show0k/lightsaber/README.md

#ENSEA-lightsaber

Project made during the ENSEA 2nd year.
More documentation will be here after the new version of the sound board.

Official website [french] lightsaber.ensea.fr

#Credits
Project made by Cédric P. (tiritchi) and Théo S. (show0k) directed by our teacher M. Tauvel.
