show0k/lightsaber/soft/README.md

#HOW TO USE THAT STUF
To compile the project, the easiest is 
* download, extract and install the arduino IDE corresonding to your OS (tested with v1.0.5)
* copy the librairy directory to your local arduino directory named librairy
** On GNU/Linux it is ~/sketchbook/libraries/ 
** On MacOS it is ~/Arduino/librairies/
** On Windows it is
* Open lightsaber.ino with your arduino IDE, and compile corresponding to your board.

#Advise
Arduino IDE is awfull, use the stino pluggin on SublimeText instead.

0665033470
