show0k/lightsaber/website/README.md

Samples pages that will be copied to http://lightsaber.ensea.fr
