show0k/lightsaber/hard/avr/328p/README.md

Board with ATMEGA328p directly wired.
Never fishish because is was to long to route it for the ENSEA quality.
