show0k/lightsaber/website/presentation-sabre.md

Le projet sabre laser à pout but de réaliser une réplique de l'arme fétiche de la trilogie de Star Wars.

Créer un faisceau laser très énergétique sur une distance finie étant soit disant impossible, nous nous sommes contentés de rélaliser une réplique réaliste, avec un pommeau en métal et un faiseau lumineux dans un tube diffusant. Le tout est équipé d'une carte électronique qui produit des sons de façon réaliste selon les mouvements de l'utilisateur.

Tout le projet est sous licence MIT, il est hébergé sur un dépôt git sur [GitHub](http://github.com/show0k/lightsaber). Vous pouvez télécharger [l'archive complete](https://github.com/show0k/lightsaber/archive/master.zip) ou [cloner le dépôt](git clone git@github.com:show0k/lightsaber.git). Soyez libre de proposer des amélioration ou soulever des problèmes avec le [gestionaire de bugs](https://github.com/show0k/lightsaber/issues) intégré à Github.
