show0k/lightsaber/website/credits.md

# Réalisation du sabre laser
Tout le projet a été réalisé par Cédric P. et Théo S. au cours du projet de deuxième année de l'ENSEA, encadré par [M. Tauvel](http://www.tauvel.net/).

Les librairies utilisées pour ce projet sont sous licence MIT (ADXL345) et GPL (FatReader et WaveHC).

Tout le code ainsi que les cartes électroniques de ce projet sont placés sous la licence MIT, ce qui autorise quiconque à utiliser, modifier et redistribuer les sources de notre projet à la seule condition de mentioner les auteurs originaux.

Tout le projet est hébergé sur un dépôt git sur [GitHub](http://github.com/show0k/lightsaber). Vous pouvez télécharger [l'archive complete](https://github.com/show0k/lightsaber/archive/master.zip) ou [cloner le dépôt](git@github.com:show0k/lightsaber.git). 
Si vous réalisez une carte de sabre laser en utilisant notre projet, c'est toujours agréable de recevoir un mail. Vous pouvez nous écrire à ***lightsaber @ ensea.fr***

# Site web
Ce site web est propulsé par [PluXml](http://www.pluxml.org/) avec un thème crée par [Fred](http://my.pluxml.free.fr/pluxml/) utilisant [Bootstrap](http://getbootstrap.com/) et adapté par nous même pour nos besoins.
