show0k/lightsaber/hard/avr/pro_mini/images/avr_saber_mini.sch.png

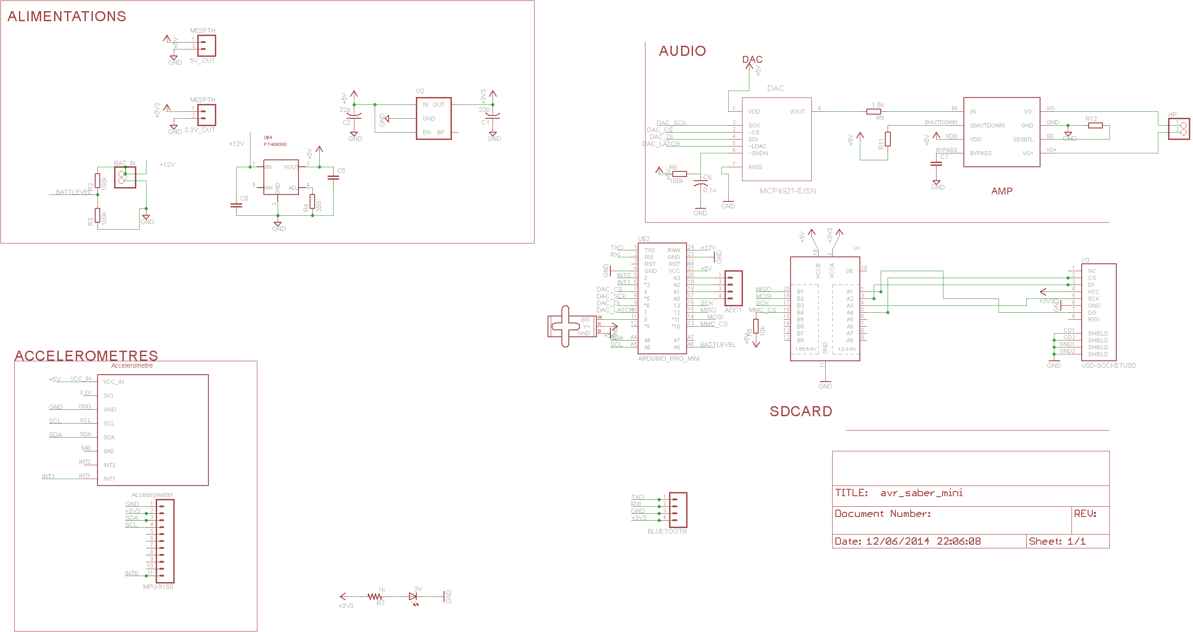
hard/avr/pro_mini/images/avr_saber_mini.sch.png
