show0k/lightsaber/hard/avr/pro_mini/images/bottom.png

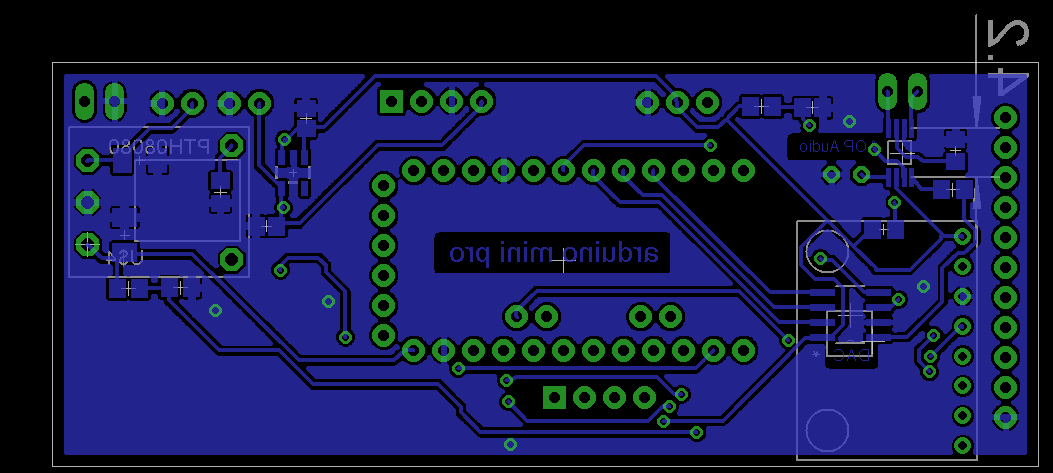
hard/avr/pro_mini/images/bottom.png
