show0k/lightsaber/hard/avr/pro_mini/images/top.png

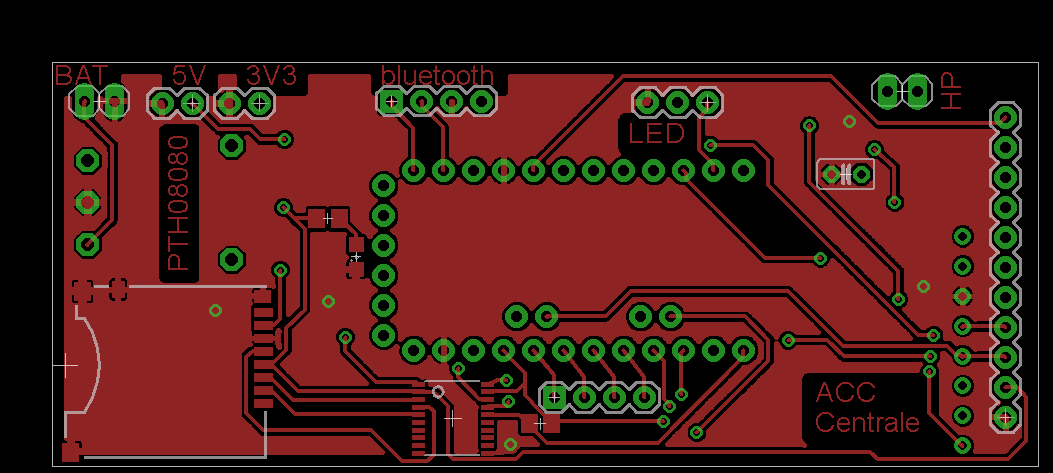
hard/avr/pro_mini/images/top.png
