show0k/lightsaber/hard/led/led_saber.bottom.pdf

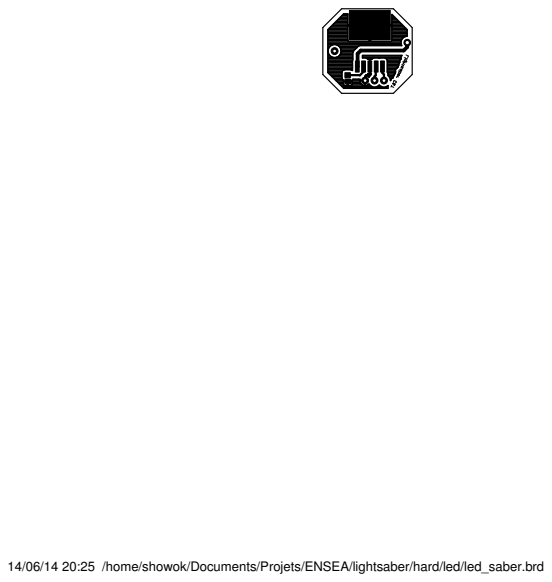
[picture p10: page 1]

14/06/14 20:25 /home/showok/Documents/Projets/ENSEA/lightsaber/hard/led/led_saber.brd
