show0k/lightsaber/hard/led/led_saber.top.pdf

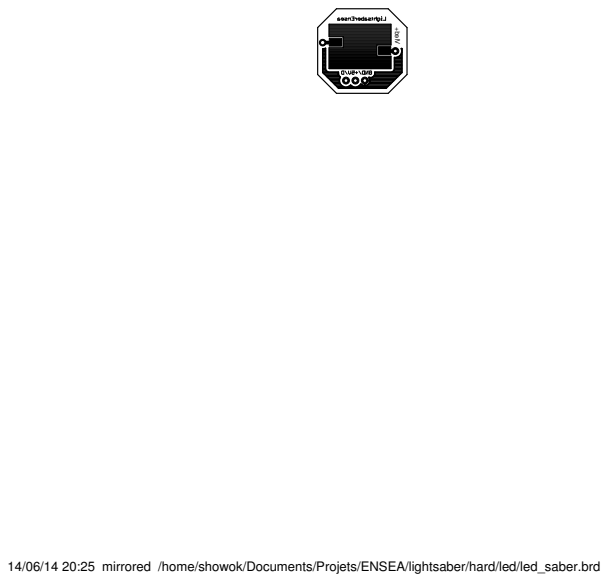
[picture p11: page 1]

14/06/14 20:25 mirrored /home/showok/Documents/Projets/ENSEA/lightsaber/hard/led/led_saber.brd
