show0k/lightsaber/hard/avr/pro_mini/avr_saber_mini.pdf

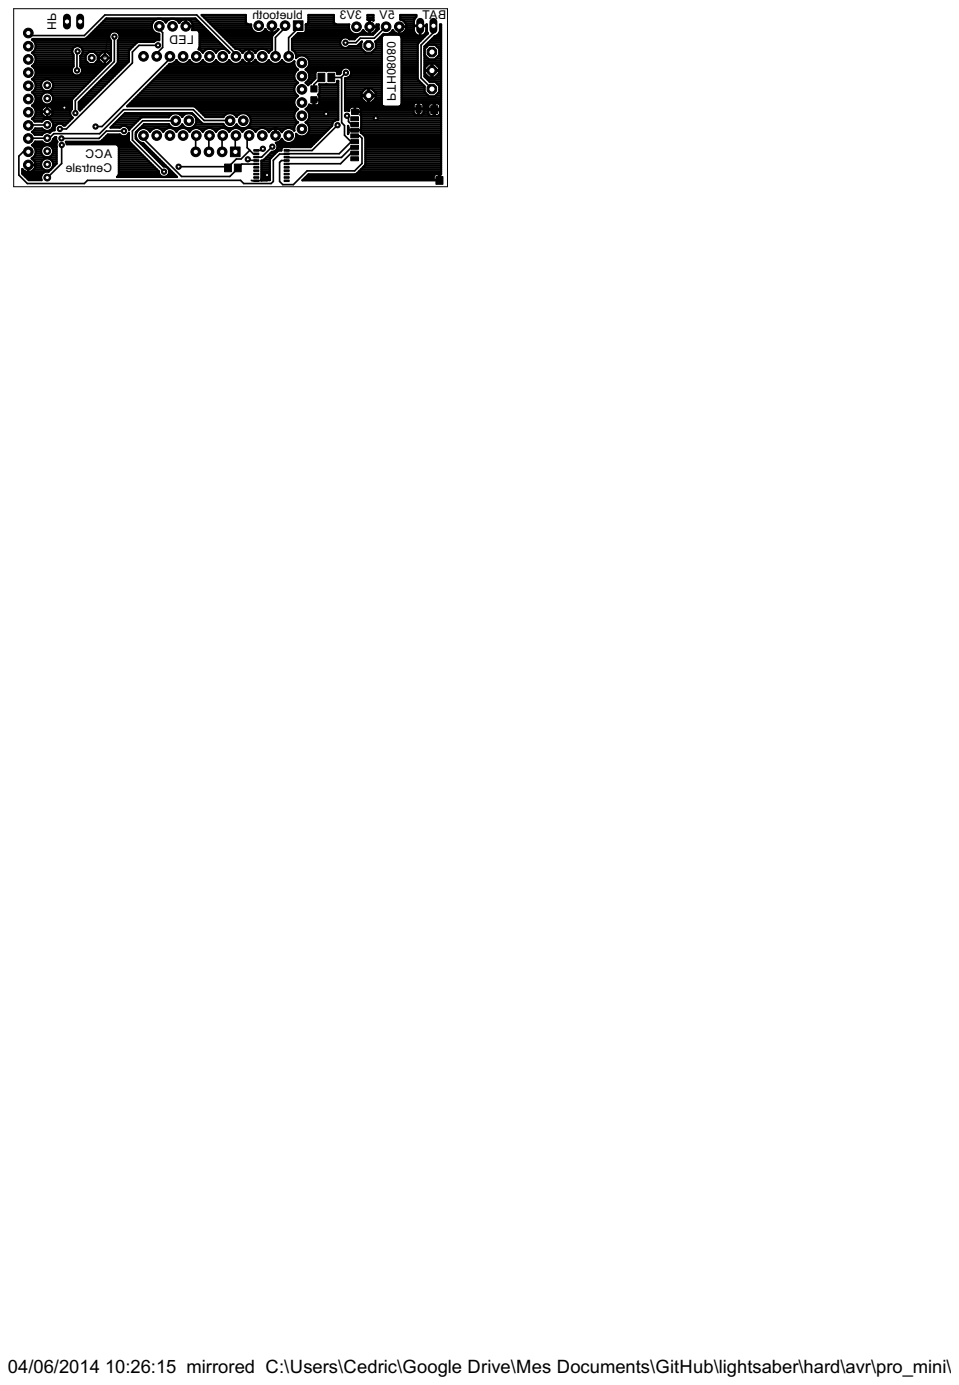
[picture p12: page 1]

04/06/2014 10:26:15 mirrored C:\Users\Cedric\Google Drive\Mes Documents\GitHub\lightsaber\hard\avr\pro_mini\
