show0k/lightsaber/hard/led/led_saber.brd

## EAGLE design hard/led/led_saber.brd (2014-06-29)

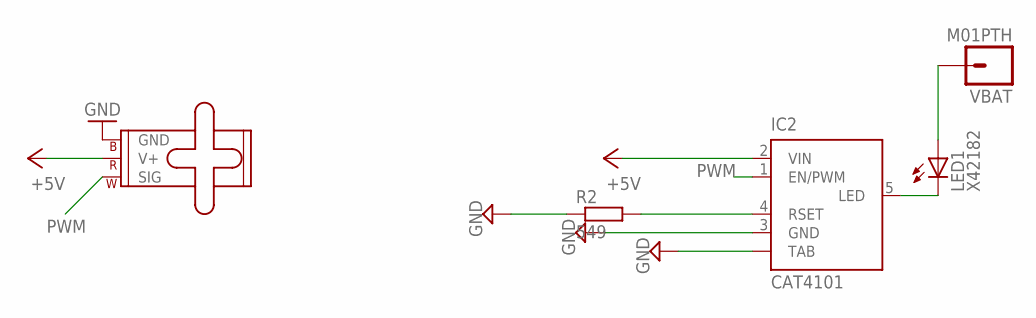
[picture p13: schematic led_saber.sch]

Parts:
IC2: CAT4101; TO263_5
LED: SMALL_SERVO; 1X03
LED1: X42182; Z-POWER-LED-DOME-TYPE
R2: 549; R0805
VBAT: M01PTH; 1X01

Connections:
+5V: IC2.2 (VIN), LED.2 (V+)
GND: IC2.3 (GND), IC2.TAB, LED.3 (GND), R2.1
unnamed: IC2.5 (LED), LED1.C
unnamed: IC2.4 (RSET), R2.2
unnamed: LED1.A, VBAT.1
PWM: IC2.1 (EN/PWM), LED.1 (SIG)

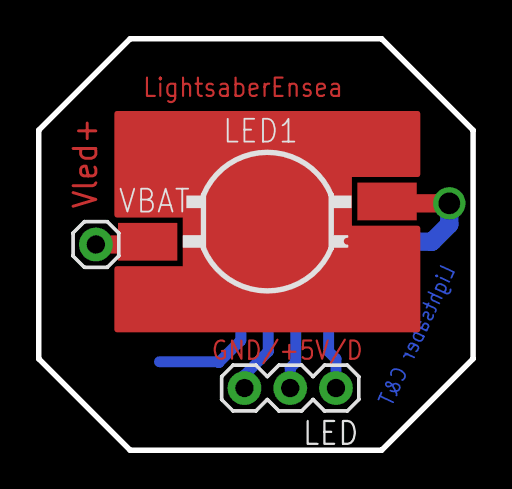
[picture p14: board led_saber.brd from above]

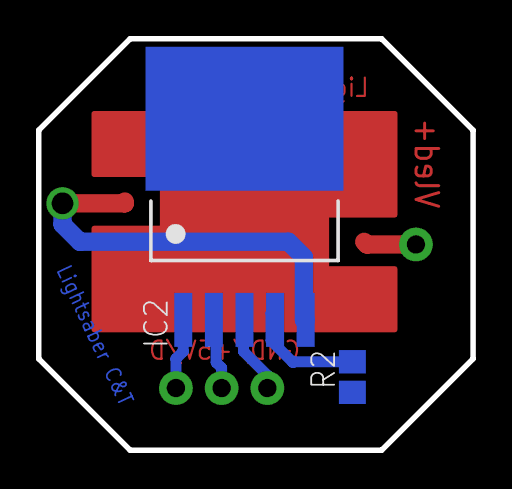
[picture p15: board led_saber.brd from below]

Board: 2 copper layers, 24.1 x 22.9 mm, 5 parts (2 on the bottom side), 6 nets.
