show0k/lightsaber/hard/avr/328p/avr_saber.brd

## EAGLE design hard/avr/328p/avr_saber.brd (2014-06-03)

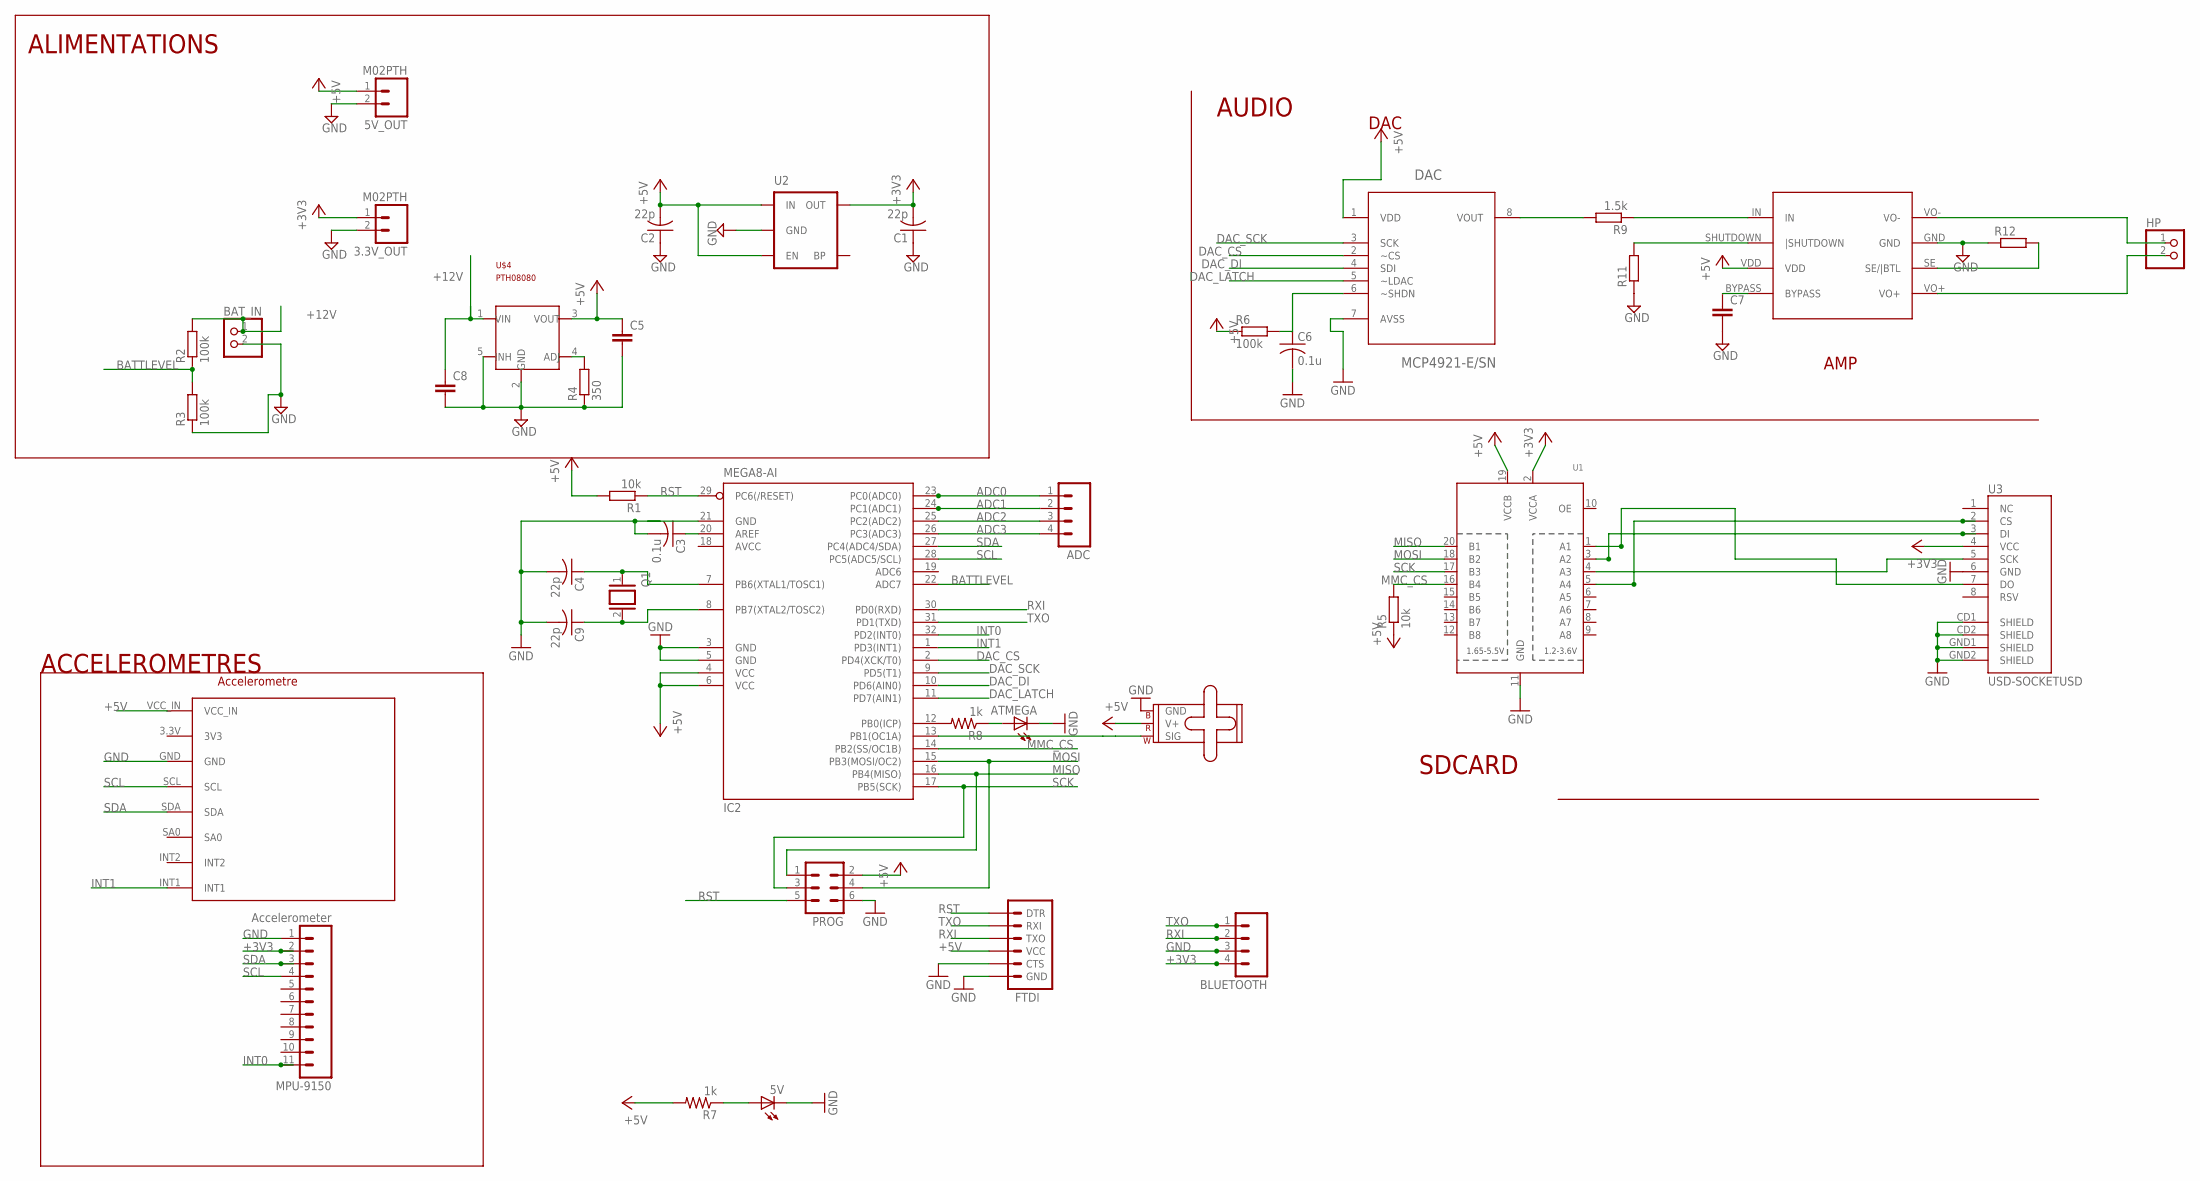
[picture p16: schematic avr_saber.sch]

Parts:
3.3V_OUT, 5V_OUT: M02PTH; 1X02
5V: LEDSML0805; SML0805
ADC: M04PTH; 1X04
ATMEGA: LEDSML0805; SML0805
BAT_IN: PINHD-1X2; 1X02
BLUETOOTH: M04PTH; 1X04
C1, C2, C4, C9: 22p; C0805
C3, C6: 0.1u; C0805
C5, C8: C-EUC1206K; C1206K
C7: C-EU025-025X050; C025-025X050
DAC: MCP4921-E/SN; SOIC8-N_MC
FTDI: ARDUINO_SERIAL_PROGRAMPTH; 1X06
HP: PINHD-1X2; 1X02
IC2: MEGA8-AI; TQFP32-08
LED: SMALL_SERVO; 1X03
MMA8451: DEV; MMA8451
MPU-9150: Accelerometer; 1X11
PROG: MA03-2
Q1: XTAL/S; QS
R1, R5: 10k; R0805
R2, R3, R6: 100k; R0805
R4: 350; R0805
R7, R8: 1k; M0805
R9: 1.5k; R0805
R11, R12: R-EU_R0805; R0805
U1: TXB0108PWR; TSSOP20
U2: MIC52053.3V; SOT23-5
U3: USD-SOCKETUSD; USD-SOCKET-PP
U$1: TPA0211
U$4: PTH08080; PTH08080EUF

Connections:
+3V3: 3.3V_OUT.1, BLUETOOTH.4, C1.2, MPU-9150.2, U1.2 (VCCA), U2.5 (OUT), U3.4 (VCC)
+5V: 5V_OUT.1, C2.2, C5.1, DAC.1 (VDD), FTDI.4 (VCC), IC2.4 (VCC), IC2.6 (VCC), LED.2 (V+), MMA8451.VCC_IN, PROG.2, R1.2, R5.1, R6.1, R7.2, U1.19 (VCCB), U2.1 (IN), U2.3 (EN), U$1.VDD, U$4.3 (VOUT)
+12V: BAT_IN.1, C8.1, R2.2, U$4.1 (VIN)
ADC0: ADC.1, IC2.23 (PC0(ADC0))
ADC1: ADC.2, IC2.24 (PC1(ADC1))
ADC2: ADC.3, IC2.25 (PC2(ADC2))
ADC3: ADC.4, IC2.26 (PC3(ADC3))
AVCC: IC2.18 (AVCC)
BATTLEVEL: IC2.22 (ADC7), R2.1, R3.2
DAC_CS: DAC.2 (~CS), IC2.2 (PD4(XCK/T0))
DAC_DI: DAC.4 (SDI), IC2.10 (PD6(AIN0))
DAC_LATCH: DAC.5 (~LDAC), IC2.11 (PD7(AIN1))
DAC_SCK: DAC.3 (SCK), IC2.9 (PD5(T1))
GND: 3.3V_OUT.2, 5V.C, 5V_OUT.2, ATMEGA.C, BAT_IN.2, BLUETOOTH.3, C1.1, C2.1, C3.2, C4.2, C5.2, C6.2, C7.2, C8.2, C9.2, DAC.7 (AVSS), FTDI.5 (CTS), FTDI.6 (GND), IC2.3 (GND), IC2.5 (GND), IC2.21 (GND), LED.3 (GND), MMA8451.GND, MPU-9150.1, PROG.6, R3.1, R4.1, R11.1, R12.1, U1.11 (GND), U2.2 (GND), U3.6 (GND), U3.CD1 (SHIELD), U3.CD2 (SHIELD), U3.GND1 (SHIELD), U3.GND2 (SHIELD), U$1.GND, U$4.2 (GND), U$4.5 (INH)
INT0: IC2.32 (PD2(INT0)), MPU-9150.11
INT1: IC2.1 (PD3(INT1)), MMA8451.INT1
MISO: IC2.16 (PB4(MISO)), PROG.1, U1.20 (B1)
MMC_CS: IC2.14 (PB2(SS/OC1B)), R5.2, U1.16 (B4)
MOSI: IC2.15 (PB3(MOSI/OC2)), PROG.4, U1.18 (B2)
unnamed: C9.1, IC2.8 (PB7(XTAL2/TOSC2)), Q1.2
unnamed: C4.1, IC2.7 (PB6(XTAL1/TOSC1)), Q1.1
unnamed: R9.1, U$1.IN
unnamed: R4.2, U$4.4 (ADJ)
unnamed: U1.4 (A3), U3.5 (SCK)
unnamed: U1.1 (A1), U3.7 (DO)
unnamed: C3.1, IC2.20 (AREF)
unnamed: U1.5 (A4), U3.2 (CS)
unnamed: 5V.A, R7.1
unnamed: U1.3 (A2), U3.3 (DI)
unnamed: ATMEGA.A, R8.1
unnamed: IC2.12 (PB0(ICP)), R8.2
unnamed: DAC.8 (VOUT), R9.2
unnamed: C6.1, DAC.6 (~SHDN), R6.2
unnamed: IC2.13 (PB1(OC1A)), LED.1 (SIG)
unnamed: HP.1, U$1.VO-
unnamed: C7.1, U$1.BYPASS
unnamed: R11.2, U$1.SHUTDOWN (|SHUTDOWN)
unnamed: R12.2, U$1.SE (SE/|BTL)
RST: FTDI.1 (DTR), IC2.29 (PC6(/RESET)), PROG.5, R1.1
RXI: BLUETOOTH.2, FTDI.3 (TXO), IC2.30 (PD0(RXD))
SCK: IC2.17 (PB5(SCK)), PROG.3, U1.17 (B3)
SCL: IC2.28 (PC5(ADC5/SCL)), MMA8451.SCL, MPU-9150.4
SDA: IC2.27 (PC4(ADC4/SDA)), MMA8451.SDA, MPU-9150.3
TXO: BLUETOOTH.1, FTDI.2 (RXI), IC2.31 (PD1(TXD))
VO+: HP.2, U$1.VO+

Notes on the sheet:
DAC
AMP
Accelerometre
ALIMENTATIONS
ACCELEROMETRES
AUDIO
SDCARD

Board: 2 copper layers, 41 parts (24 on the bottom side), 44 nets, no tracks yet.
