show0k/lightsaber/hard/avr/pro_mini/avr_saber_mini.brd

## EAGLE design hard/avr/pro_mini/avr_saber_mini.brd (2014-06-29)

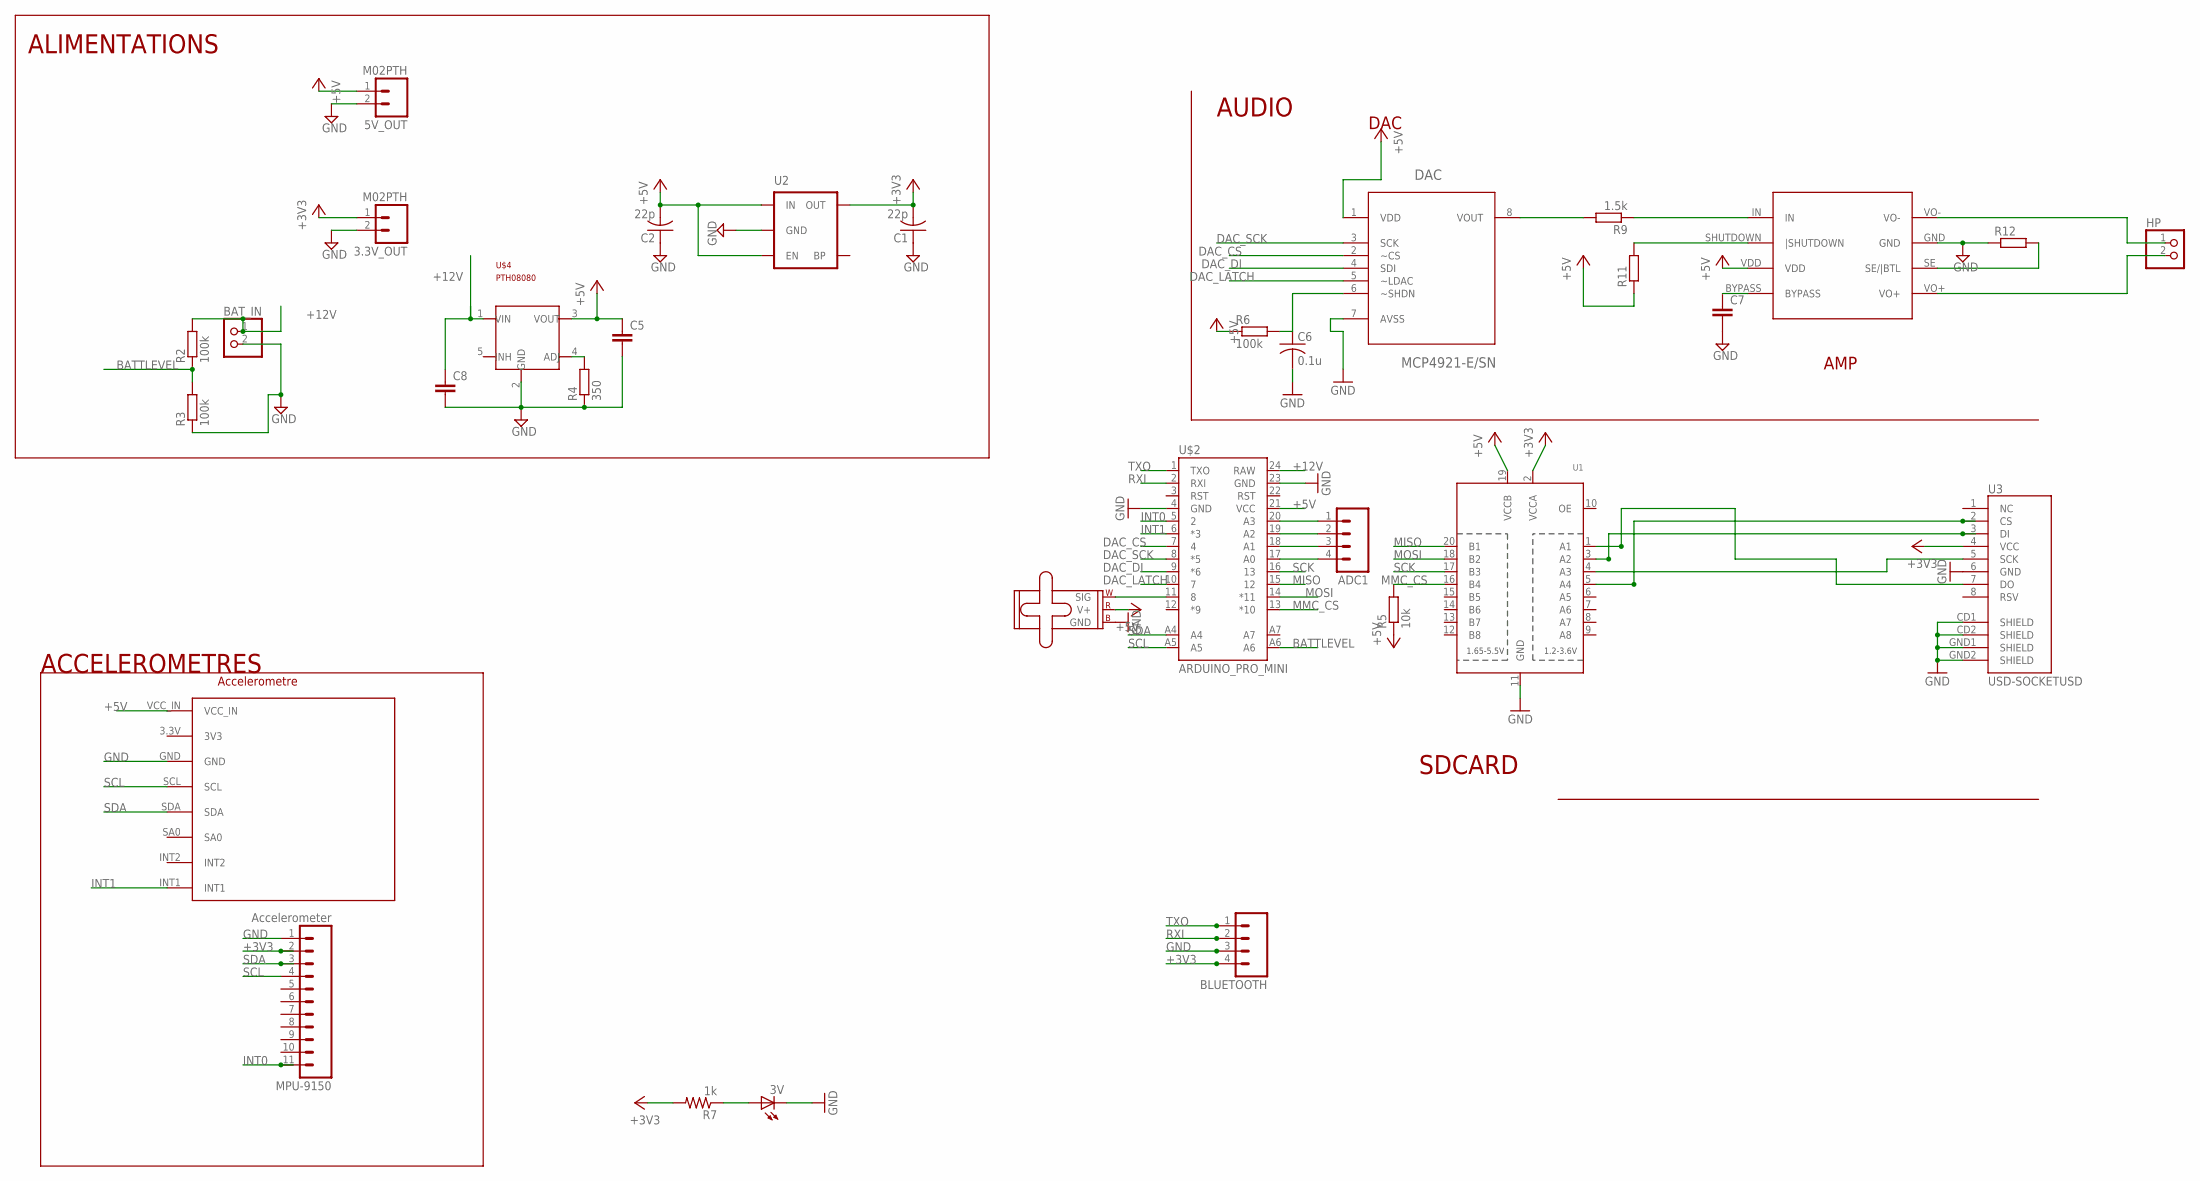
[picture p17: schematic avr_saber_mini.sch]

Parts:
3.3V_OUT, 5V_OUT: M02PTH; 1X02
3V: LEDSML0805; SML0805
ADC1: M04PTH; 1X04
BAT_IN: PINHD-1X2; 1X02
BLUETOOTH: M04PTH; 1X04
C1, C2: 22p; C0805
C5, C8: C-EUC1206K; C1206K
C6: 0.1u; C0805
C7: C-EU025-025X050; C025-025X050
DAC: MCP4921-E/SN; SOIC8-N_MC
HP: PINHD-1X2; 1X02
LED1: SMALL_SERVO; 1X03
MMA8451: DEV; MMA8451
MPU-9150: Accelerometer; 1X11
R2, R3, R6: 100k; R0805
R4: 350; R0805
R5: 10k; R0805
R7: 1k; M0805
R9: 1.5k; R0805
R11, R12: R-EU_R0805; R0805
U1: TXB0108PWR; TSSOP20
U2: MIC52053.3V; SOT23-5
U3: USD-SOCKETUSD; USD-SOCKET-PP
U$1: TPA0211
U$2: ARDUINO_PRO_MINI
U$4: PTH08080; PTH08080EUF

Connections:
+3V3: 3.3V_OUT.1, BLUETOOTH.4, C1.2, MPU-9150.2, R7.2, U1.2 (VCCA), U2.5 (OUT), U3.4 (VCC)
+5V: 5V_OUT.1, C2.2, C5.1, DAC.1 (VDD), LED1.2 (V+), MMA8451.VCC_IN, R5.1, R6.1, R11.1, U1.19 (VCCB), U2.1 (IN), U2.3 (EN), U$1.VDD, U$2.21 (VCC), U$4.3 (VOUT)
+12V: BAT_IN.1, C8.1, R2.2, U$2.24 (RAW), U$4.1 (VIN)
BATTLEVEL: R2.1, R3.2, U$2.A6
DAC_CS: DAC.2 (~CS), U$2.7 (4)
DAC_DI: DAC.4 (SDI), U$2.9 (*6)
DAC_LATCH: DAC.5 (~LDAC), U$2.10 (7)
DAC_SCK: DAC.3 (SCK), U$2.8 (*5)
GND: 3.3V_OUT.2, 3V.C, 5V_OUT.2, BAT_IN.2, BLUETOOTH.3, C1.1, C2.1, C5.2, C6.2, C7.2, C8.2, DAC.7 (AVSS), LED1.3 (GND), MMA8451.GND, MPU-9150.1, R3.1, R4.1, R12.1, U1.11 (GND), U2.2 (GND), U3.6 (GND), U3.CD1 (SHIELD), U3.CD2 (SHIELD), U3.GND1 (SHIELD), U3.GND2 (SHIELD), U$1.GND, U$2.4 (GND), U$2.23 (GND), U$4.2 (GND)
INT0: MPU-9150.11, U$2.5 (2)
INT1: MMA8451.INT1, U$2.6 (*3)
MISO: U1.20 (B1), U$2.15 (12)
MMC_CS: R5.2, U1.16 (B4), U$2.13 (*10)
MOSI: U1.18 (B2), U$2.14 (*11)
unnamed: R9.1, U$1.IN
unnamed: ADC1.1, U$2.20 (A3)
unnamed: R4.2, U$4.4 (ADJ)
unnamed: U1.4 (A3), U3.5 (SCK)
unnamed: U1.1 (A1), U3.7 (DO)
unnamed: U1.5 (A4), U3.2 (CS)
unnamed: 3V.A, R7.1
unnamed: U1.3 (A2), U3.3 (DI)
unnamed: ADC1.2, U$2.19 (A2)
unnamed: DAC.8 (VOUT), R9.2
unnamed: ADC1.3, U$2.18 (A1)
unnamed: ADC1.4, U$2.17 (A0)
unnamed: LED1.1 (SIG), U$2.11 (8)
unnamed: C6.1, DAC.6 (~SHDN), R6.2
unnamed: HP.1, U$1.VO-
unnamed: C7.1, U$1.BYPASS
unnamed: R11.2, U$1.SHUTDOWN (|SHUTDOWN)
unnamed: R12.2, U$1.SE (SE/|BTL)
RXI: BLUETOOTH.2, U$2.2 (RXI)
SCK: U1.17 (B3), U$2.16 (13)
SCL: MMA8451.SCL, MPU-9150.4, U$2.A5
SDA: MMA8451.SDA, MPU-9150.3, U$2.A4
TXO: BLUETOOTH.1, U$2.1 (TXO)
VO+: HP.2, U$1.VO+

Notes on the sheet:
DAC
AMP
Accelerometre
ALIMENTATIONS
ACCELEROMETRES
AUDIO
SDCARD

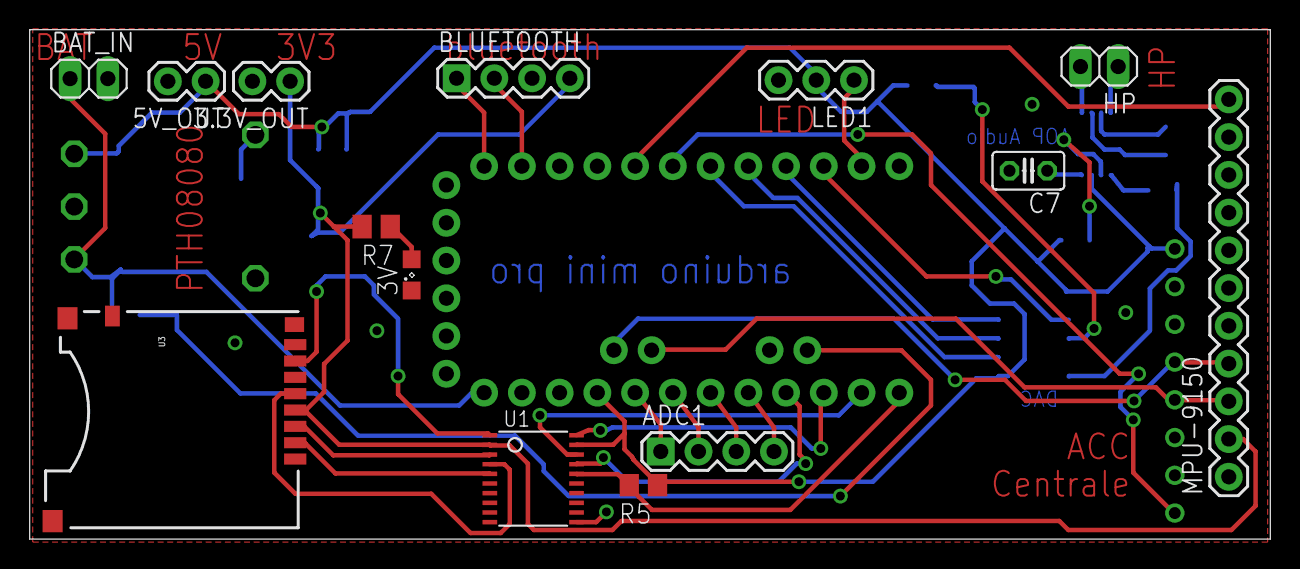
[picture p18: board avr_saber_mini.brd from above]

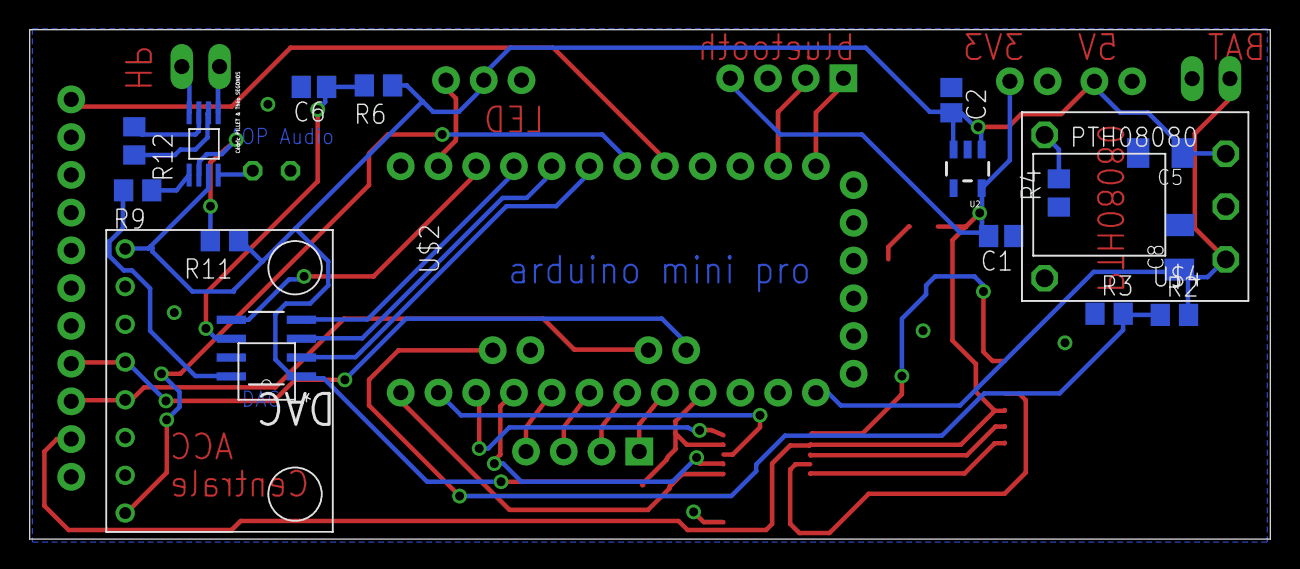
[picture p19: board avr_saber_mini.brd from below]

Board: 2 copper layers, 83.5 x 34.3 mm, 32 parts (18 on the bottom side), 38 nets.
