show0k/lightsaber/hard/ampli/ampli.brd

## EAGLE design hard/ampli/ampli.brd (2014-06-29)

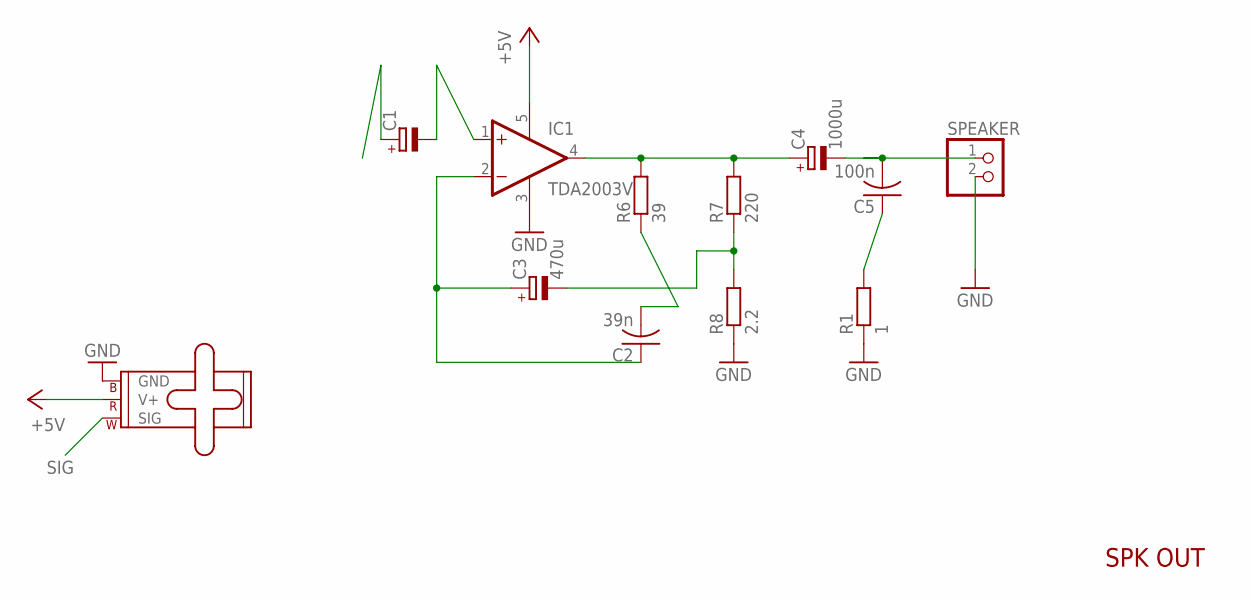
[picture p20: schematic ampli.sch]

Parts:
C1: CPOL-EUE2.5-6; E2,5-6
C2: 39n; C0805
C3: 470u; E2,5-6
C4: 1000u; E2,5-6
C5: 100n; C0805
IC1: TDA2003V; CB360
LED: SMALL_SERVO; 1X03
R1: 1; R0805
R6: 39; R0805
R7: 220; R0805
R8: 2.2; R0805
SPEAKER: PINHD-1X2; 1X02

Connections:
+5V: IC1.5 (V+), LED.2 (V+)
GND: IC1.3 (GND), LED.3 (GND), R1.1, R8.1, SPEAKER.2
unnamed: C1.-, IC1.1 (+IN)
unnamed: C2.2, R6.1
unnamed: C5.1, R1.2
unnamed: C3.-, R7.1, R8.2
unnamed: C2.1, C3.+, IC1.2 (-IN)
unnamed: C4.-, C5.2, SPEAKER.1
unnamed: C4.+, IC1.4 (OUT), R6.2, R7.2
SIG: C1.+, LED.1 (SIG)

Notes on the sheet:
SPK OUT

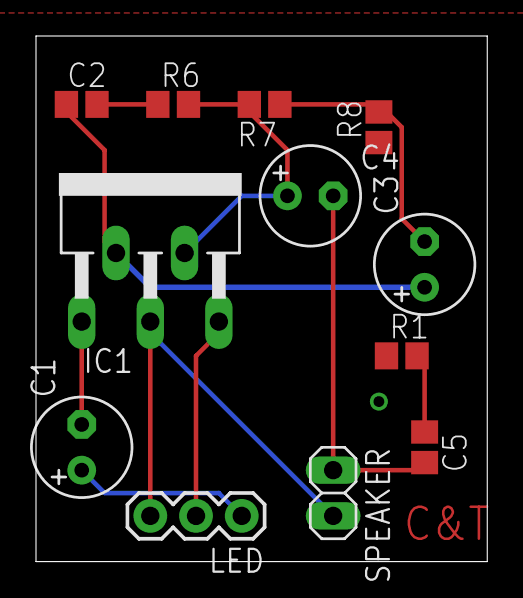
[picture p21: board ampli.brd from above]

Board: 2 copper layers, 25.1 x 29.2 mm, 12 parts (0 on the bottom side), 10 nets.
