show0k/lightsaber/hard/mbed/test board.brd

## EAGLE design hard/mbed/test board.brd (2014-06-02)

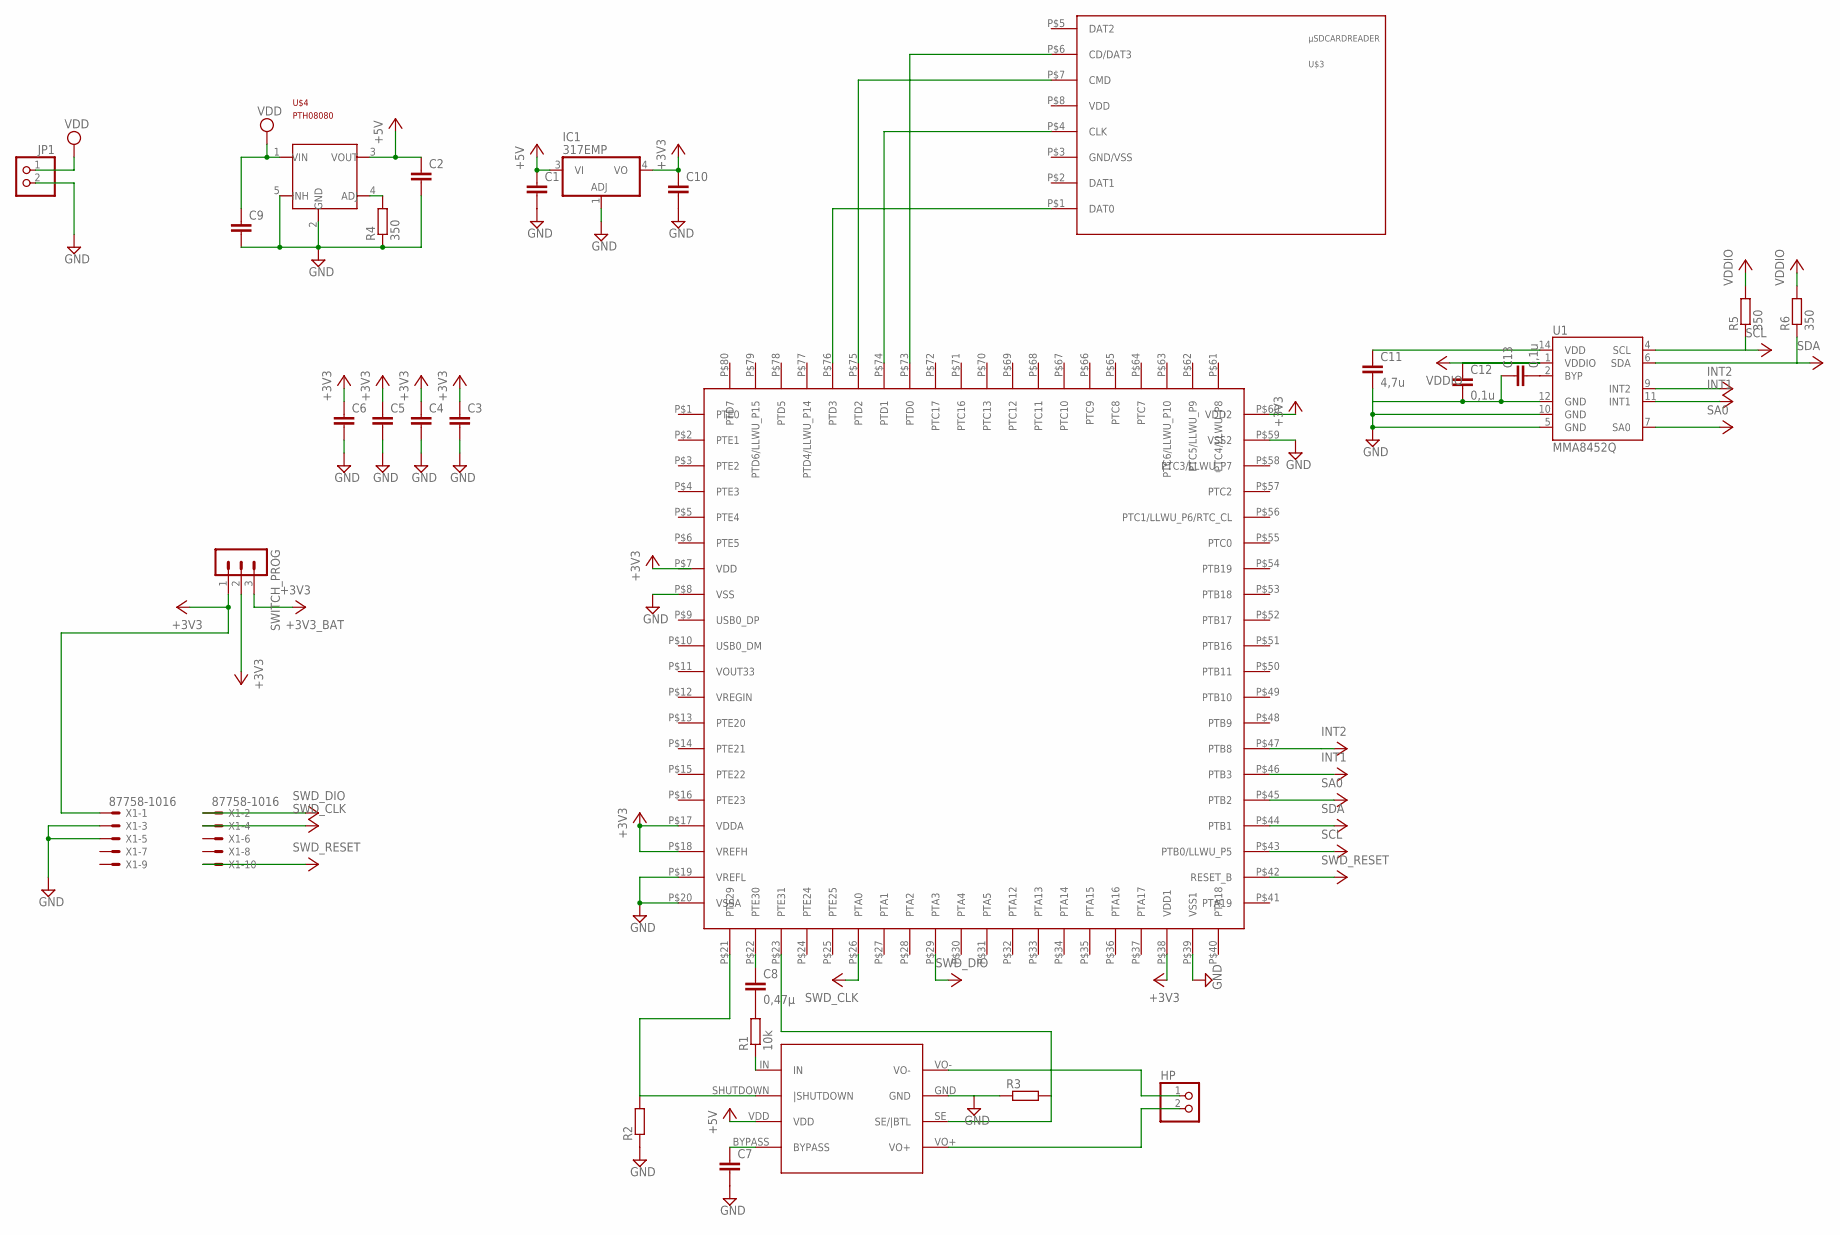
[picture p22: schematic test board.sch]

Parts:
C1, C2, C3, C4, C5, C6, C9, C10: C-EUC1206K; C1206K
C7: C-EU025-025X050; C025-025X050
C8: 0,47µ; C1206K
C11: 4,7u; C1206K
C12, C13: 0,1u; C1206K
HP: PINHD-1X2; 1X02
IC1: 317EMP; SOT223
JP1: PINHD-1X2; 1X02
R1: 10k; R0805
R2, R3: R-EU_R0805; R0805
R4, R5, R6: 350; R0805
SWITCH_PROG: MA03-1
U1: MMA8452Q; QFN-16_0.5MM
U$1: TPA0211
U$2: KL25Z_LQFP80
U$3: µSDCARDREADER; MICROSD
U$4: PTH08080; PTH08080EUF
X1: 87758-1016

Connections:
+3V3: C3.1, C4.1, C5.1, C6.1, C11.1, C12.1, R5.2, R6.2, SWITCH_PROG.2, U1.1 (VDDIO), U1.14 (VDD), U$2.P$17 (VDDA), U$2.P$18 (VREFH), U$2.P$38 (VDD1), U$2.P$60 (VDD2)
+3V3_BAT: C10.1, IC1.4 (VO), SWITCH_PROG.3
+3V3_SWD: SWITCH_PROG.1, X1.1
+5V: C1.1, C2.1, IC1.3 (VI), U$1.VDD, U$4.3 (VOUT)
GND: C1.2, C2.2, C3.2, C4.2, C5.2, C6.2, C7.2, C9.2, C10.2, C11.2, C12.2, C13.1, IC1.1 (ADJ), JP1.2, R2.1, R3.1, R4.1, U1.5 (GND), U1.10 (GND), U1.12 (GND), U$1.GND, U$2.P$8 (VSS), U$2.P$19 (VREFL), U$2.P$20 (VSSA), U$2.P$39 (VSS1), U$2.P$59 (VSS2), U$4.2 (GND), U$4.5 (INH), X1.3, X1.5
INT1: U1.11 (INT1), U$2.P$46 (PTB3)
INT2: U1.9 (INT2), U$2.P$47 (PTB8)
unnamed: U$2.P$76 (PTD3), U$3.P$1 (DAT0)
unnamed: U$2.P$73 (PTD0), U$3.P$6 (CD/DAT3)
unnamed: U$2.P$75 (PTD2), U$3.P$7 (CMD)
unnamed: U$2.P$74 (PTD1), U$3.P$4 (CLK)
unnamed: C8.2, R1.2
unnamed: C7.1, U$1.BYPASS
unnamed: HP.1, U$1.VO-
unnamed: C13.2, U1.2 (BYP)
unnamed: R1.1, U$1.IN
unnamed: C8.1, U$2.P$22 (PTE30)
unnamed: R2.2, U$1.SHUTDOWN (|SHUTDOWN), U$2.P$21 (PTE29)
unnamed: R3.2, U$1.SE (SE/|BTL), U$2.P$23 (PTE31)
unnamed: R4.2, U$4.4 (ADJ)
SA0: U1.7 (SA0), U$2.P$45 (PTB2)
SCL: R5.1, U1.4 (SCL), U$2.P$43 (PTB0/LLWU_P5)
SDA: R6.1, U1.6 (SDA), U$2.P$44 (PTB1)
SWD_CLK: U$2.P$26 (PTA0), X1.4
SWD_DIO: U$2.P$29 (PTA3), X1.2
SWD_RESET: U$2.P$42 (RESET_B), X1.10
VDD: C9.1, JP1.1, U$4.1 (VIN)
VO+: HP.2, U$1.VO+

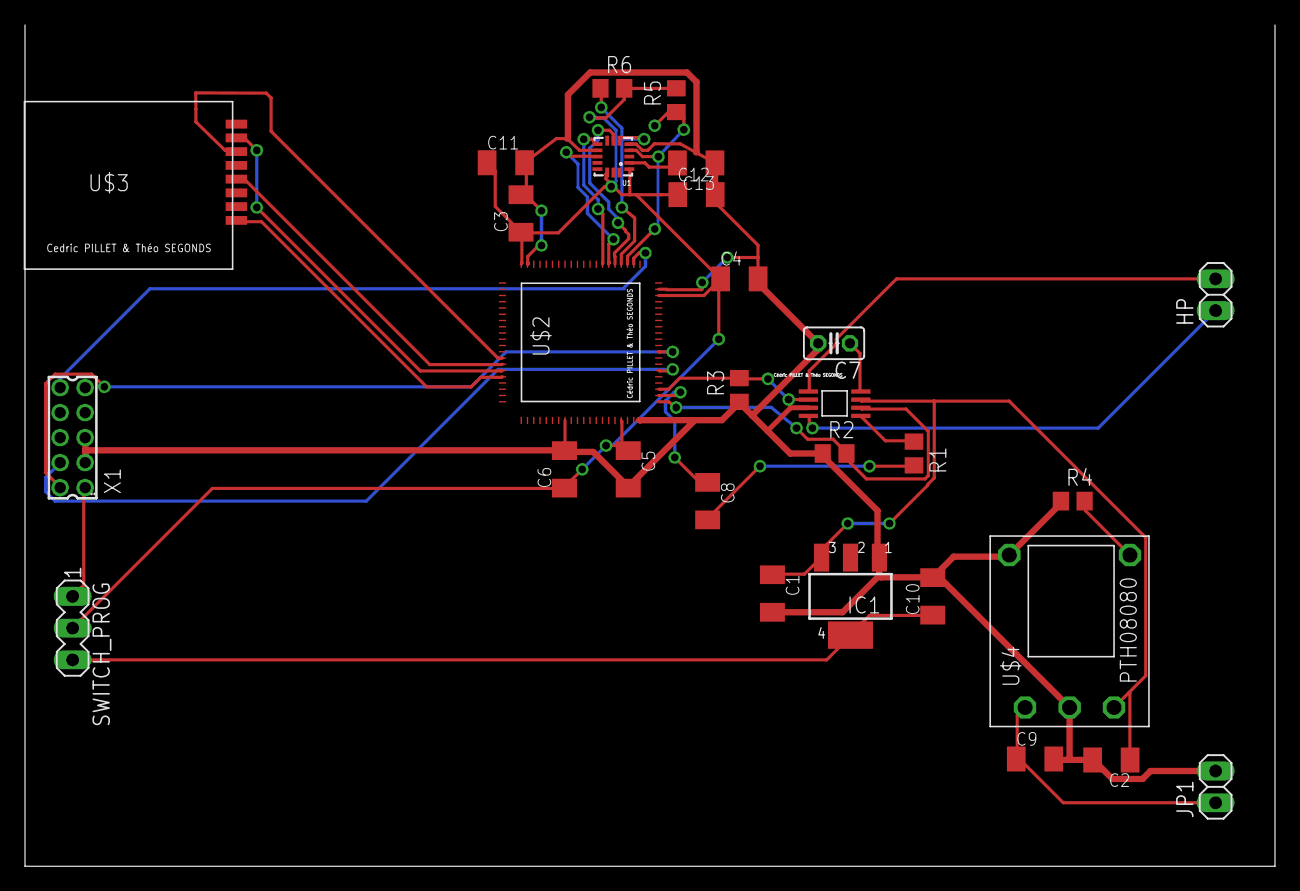
[picture p23: board test board.brd from above]

Board: 2 copper layers, 100.0 x 67.3 mm, 29 parts (0 on the bottom side), 28 nets.
