show0k/lightsaber/(commit log)

2014-06-02 akout cartes
    [avr_saber.sch, board.brd, board.sch, test board.brd, test board.sch, test board_2.brd, test board_2.sch]
2014-06-02 Ajout microSD
    [avr_saber.sch]
2014-06-02 ajout leds
    [avr_saber.sch]
2014-06-03 trying to route
    [avr_saber.brd, avr_saber.job.brd]
2014-06-03 ajout led (non finie) + shematic avec pro mini
    [avr_saber.brd, avr_saber.job.brd, avr_saber.sch, avr_saber_mini.brd, avr_saber_mini.sch, led_saber.brd, led_saber.sch, pro_mini_saber.brd]
2014-06-03 Carte led puissance terminée
    [led_saber.brd]
2014-06-03 Ajout noms sur la carte
    [led_saber.brd]
2014-06-03 new card with mini pro
    [avr_saber_mini.brd]
2014-06-05 ajout divers
    [mpu-9150_breakout.brd, mpu-9150_breakout.sch]
2014-06-05 correction inhibit pth
    [avr_saber_mini.brd, avr_saber_mini.sch]
2014-06-06 Ajout 9150
    [mpu-9150_breakout.brd, mpu-9150_breakout.sch]
2014-06-06 new version
    [avr_saber_mini.brd]
2014-06-06 board v2
    [avr_saber_mini_v2.brd, avr_saber_mini_v2.sch]
2014-06-08 ajout divers soft
    [avr_saber_mini_v2.brd, avr_saber_mini_v2.sch]
2014-06-10 ajout ampli audio + code
    [ampli.brd, ampli.sch]
2014-06-14 ajout readme divers
    [avr_saber.brd, avr_saber.job.brd, avr_saber.sch, led_saber.brd, pro_mini_saber.brd, pro_mini_saber.sch]
2014-06-14 add some readme
    [avr_saber.brd, avr_saber.sch]
2014-06-29 ajout de la dernière version de carte
    [ampli.brd, avr_saber_mini.brd, avr_saber_mini.sch]
